Awarua-/RubberEdge2/README

# RubberEdge project

For COSC411 Assignment (Advanced HCI) Dion Woolley 2017
