Awarua-/RubberEdge2/report/pages/acknowledgements.tex

\section{Acknowledgements}
I would like to acknowledge David Read, for help with the printing and cutting of the RubberEdge interface.
Andy Cockburn for putting up with me :)
