Awarua-/RubberEdge2/report/pages/glossary.tex

\printglossary[type=\acronymtype,title=ACRONYMS]
 
\printglossary
