Awarua-/RubberEdge2/CADFiles/springTouchPad 2 - innerring-1.STL

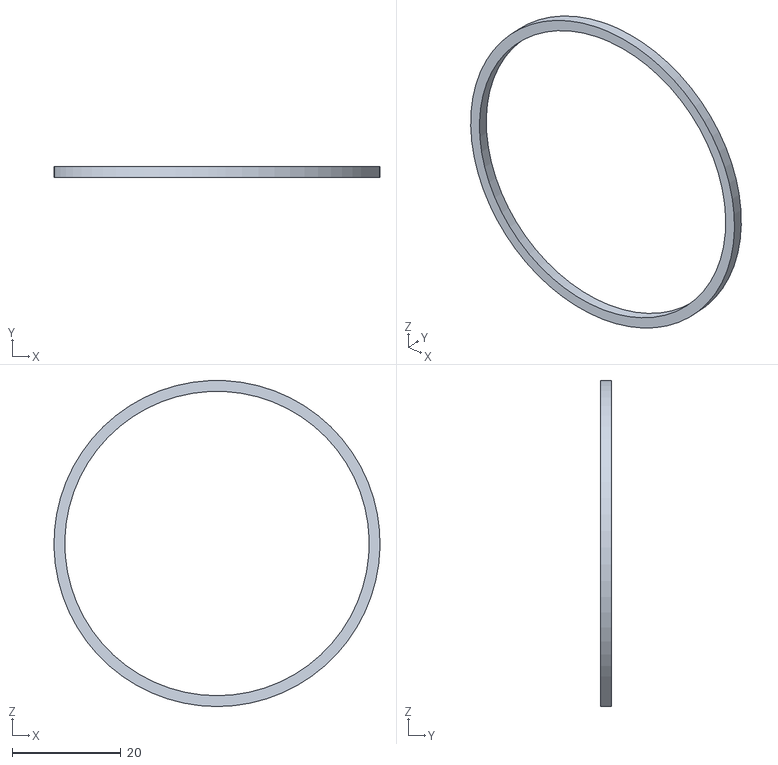
[picture p11: CAD file, 2017-06-25]
CADFiles/springTouchPad 2 - innerring-1.STL
60.0 x 2.00 x 60.0
