Awarua-/RubberEdge2/CADFiles/springTouchPad - springarms-1.STL

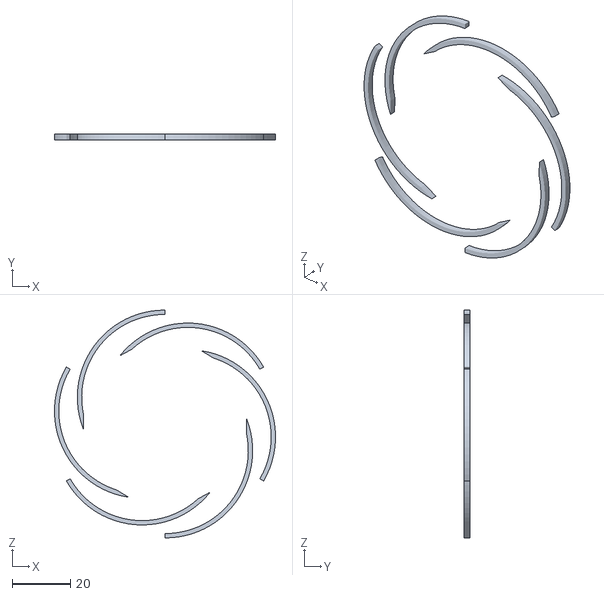
[picture p12: CAD file, 2017-06-25]
CADFiles/springTouchPad - springarms-1.STL
75.7 x 2.00 x 78.0
