Awarua-/RubberEdge2/CADFiles/springTouchPad 2 - outerframe-1.STL

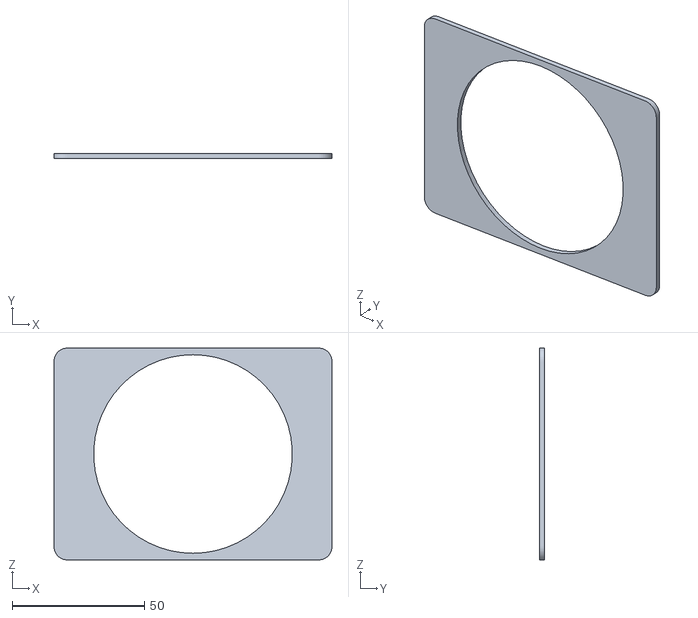
[picture p13: CAD file, 2017-06-25]
CADFiles/springTouchPad 2 - outerframe-1.STL
105.0 x 2.00 x 80.0
