Awarua-/RubberEdge2/CADFiles/springTouchPad 2 - springarms v2 extruded-1.STL

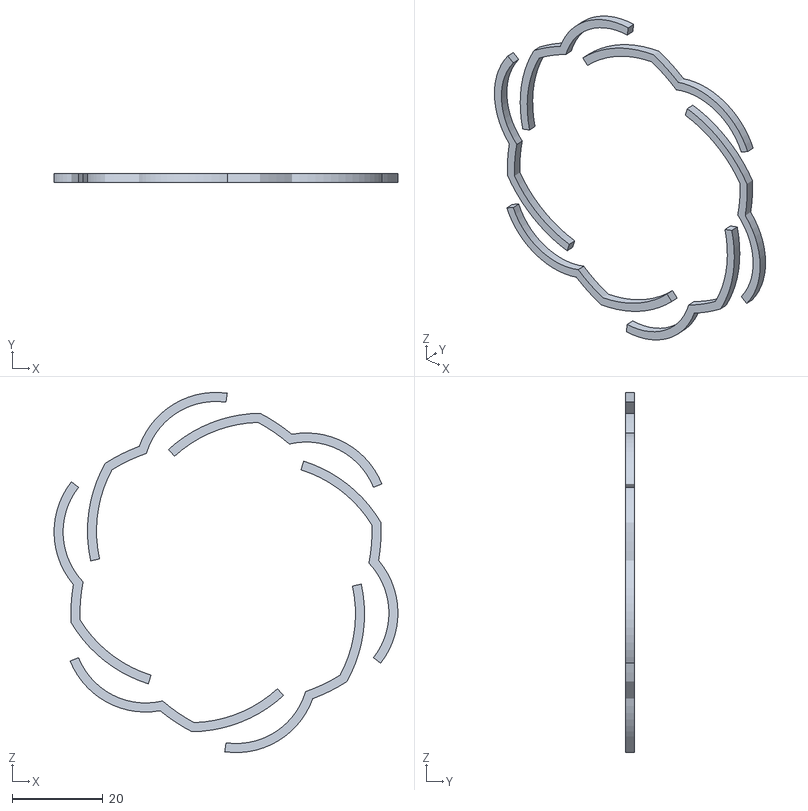
[picture p14: CAD file, 2017-06-25]
CADFiles/springTouchPad 2 - springarms v2 extruded-1.STL
75.7 x 2.00 x 79.3
