Awarua-/RubberEdge2/(list of files, cad)

Other CAD files:
CADFiles/springTouchPad - outerframe-1.STL
CADFiles/springTouchPad - innerring-1.STL
