Awarua-/RubberEdge2/(commit log)

2017-06-08 Working elastic zone, needs work for changing the velocity curve
2017-06-25 Add CAD files
    [springTouchPad - innerring-1.STL, springTouchPad - outerframe-1.STL, springTouchPad - springarms-1.STL, springTouchPad 2 - innerring-1.STL, springTouchPad 2 - outerframe-1.STL, springTouchPad 2 - springarms v2 extruded-1.STL]
